mbadzioch/helios_dac/hardware/Kicad_PCB_helios/Helios.kicad_pcb

## KiCad design hardware/Kicad_PCB_helios/Helios.kicad_pcb (2017-06-14)

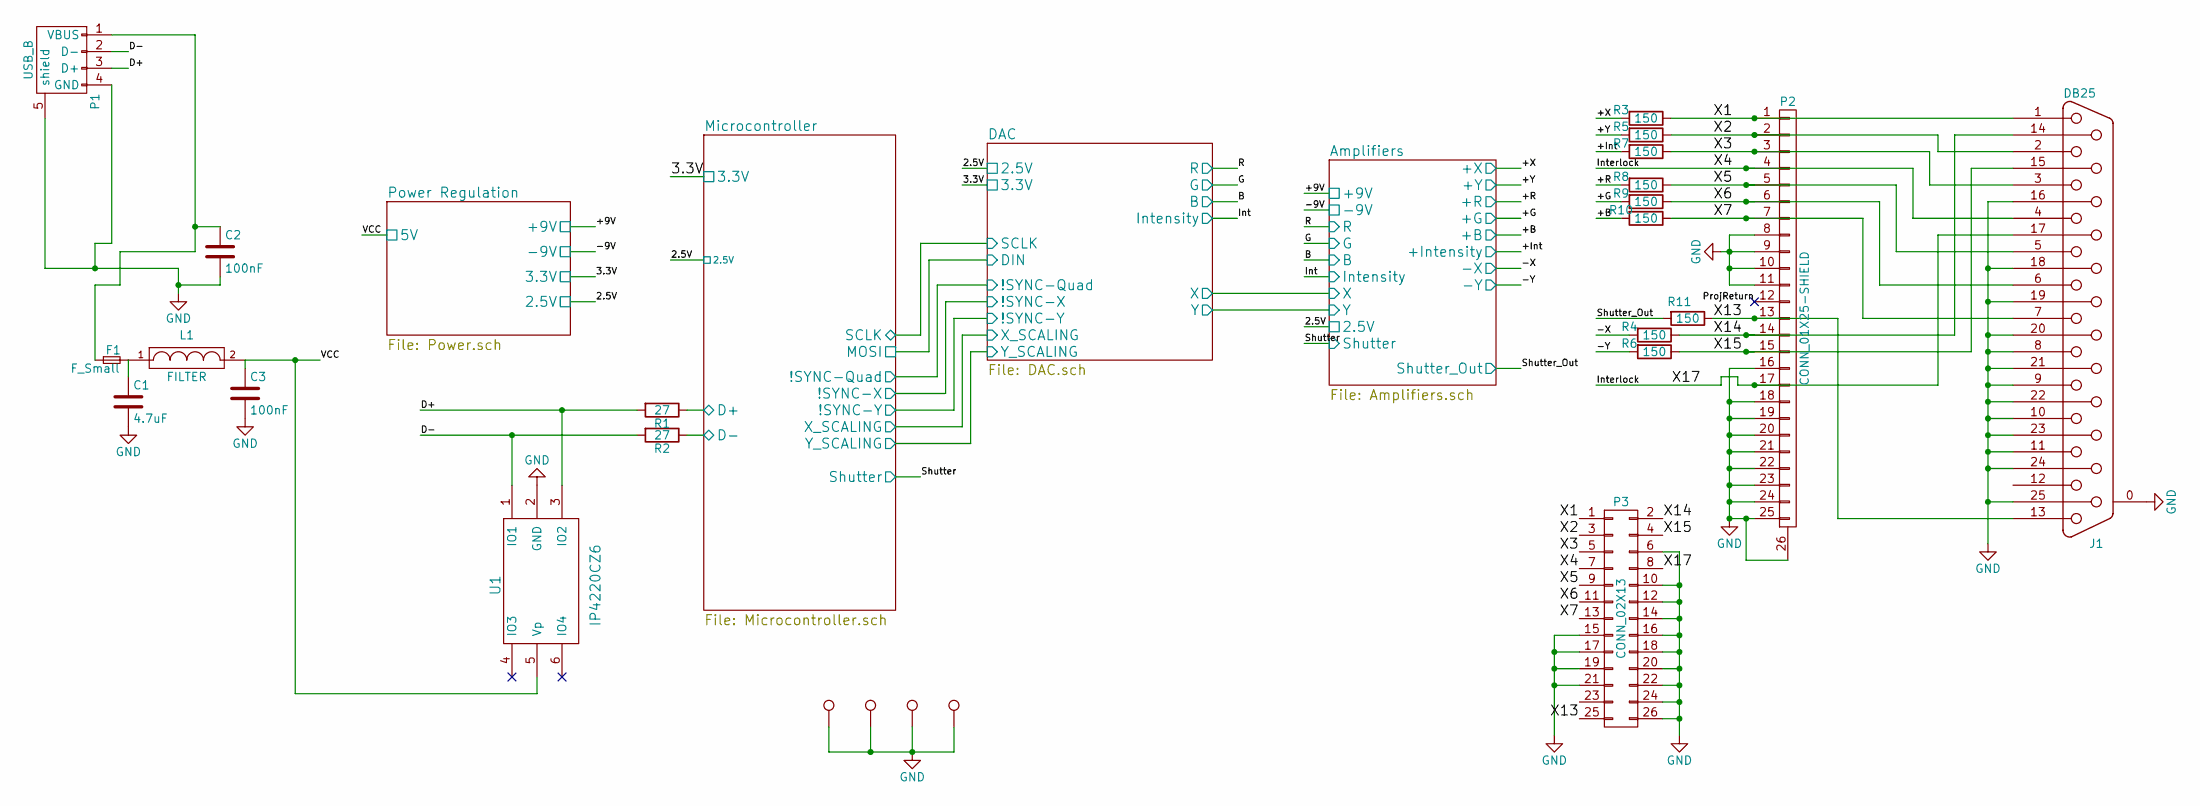
[picture p1: schematic Helios.sch, Main]

Parts:
C1: 4.7uF; c_elec_4x5.3
C2, C3: 100nF; C_0603
F1: F_Small; R_1206
J1: DB25; DB25FD
L1: FILTER; R_0603
P1: USB_B
P2: CONN_01X25-SHIELD
P3: CONN_02X13; IDC_Header_Straight_26pins
R1, R2: 27; R_0603
R3, R4, R5, R6, R7, R8, R9, R10, R11: 150; R_0603
U1: IP4220CZ6; SOT457
W1, W2, W3, W4: TEST_1P; 1pin

Connections:
/+B: R10.2; also elsewhere on the board
/+G: R9.2; also elsewhere on the board
/+Int: R7.2; also elsewhere on the board
/+R: R8.2; also elsewhere on the board
/+X: R3.2; also elsewhere on the board
/+Y: R5.2; also elsewhere on the board
/-X: R4.2; also elsewhere on the board
/-Y: R6.2; also elsewhere on the board
/D+: P1.3 (D+), R1.2, U1.3 (IO2)
/D-: P1.2 (D-), R2.2, U1.1 (IO1)
/Interlock: J1.4, J1.17, P2.4, P2.17, P3.7, P3.8
/Microcontroller/D+: R1.1; also elsewhere on the board
/Microcontroller/D-: R2.1; also elsewhere on the board
/Shutter_Out: R11.2; also elsewhere on the board
/VCC: C3.1, L1.2, U1.5 (Vp); also elsewhere on the board
/X1: J1.1, P2.1, P3.1, R3.1
/X2: J1.2, P2.2, P3.3, R5.1
/X3: J1.3, P2.3, P3.5, R7.1
/X5: J1.5, P2.5, P3.9, R8.1
/X6: J1.6, P2.6, P3.11, R9.1
/X7: J1.7, P2.7, P3.13, R10.1
/X13: J1.13, P2.13, P3.25, R11.1
/X14: J1.14, P2.14, P3.2, R4.1
/X15: J1.15, P2.15, P3.4, R6.1
GND: C1.2, C2.2, C3.2, J1.0 (GND), J1.8, J1.9, J1.10, J1.11, J1.16, J1.18, J1.19, J1.20, J1.21, J1.22, J1.23, J1.24, J1.25, P1.4 (GND), P1.5 (shield), P2.8, P2.9, P2.10, P2.11, P2.16, P2.18, P2.19, P2.20, P2.21, P2.22, P2.23, P2.24, P2.25, P2.26 (Shield), P3.6, P3.10, P3.12, P3.14, P3.15, P3.16, P3.17, P3.18, P3.19, P3.20, P3.21, P3.22, P3.24, P3.26, U1.2 (GND), W1.1, W2.1, W3.1, W4.1; also elsewhere on the board
unnamed: C1.1, F1.2, L1.1
unnamed: C2.1, F1.1, P1.1 (VBUS)

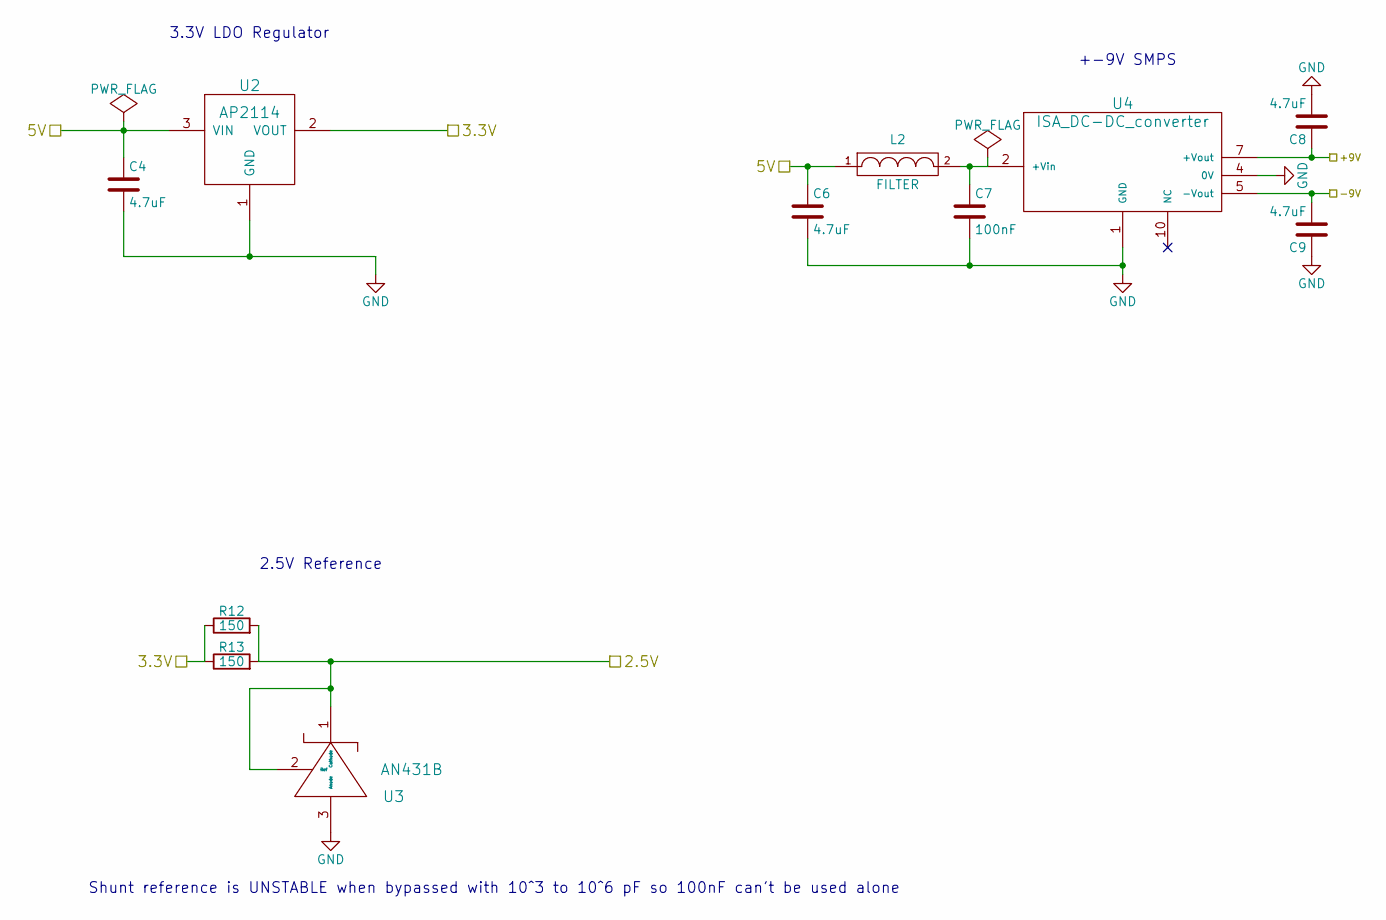
[picture p2: schematic Power.sch, Power Supplies]

Parts:
C4, C6, C8, C9: 4.7uF; c_elec_4x5.3
C7: 100nF; C_0603
L2: FILTER; R_0603
R12, R13: 150; R_0603
U2: AP2114; SOT-223
U3: AN431B; SOT-23
U4: ISA_DC-DC_converter; 10-SMD-6

Connections:
/2.5V: R12.2, R13.2, U3.1 (Cathode), U3.2 (Ref); also elsewhere on the board
/3.3V: R12.1, R13.1, U2.2 (VOUT); also elsewhere on the board
/+9V: C8.1, U4.7 (+Vout); also elsewhere on the board
/-9V: C9.2, U4.5 (-Vout); also elsewhere on the board
/VCC: C4.1, C6.1, L2.1, U2.3 (VIN); also elsewhere on the board
GND: C4.2, C6.2, C7.2, C8.2, C9.1, U2.1 (GND), U3.3 (Anode), U4.1 (GND), U4.4 (0V); also elsewhere on the board
unnamed: C7.1, L2.2, U4.2 (+Vin)

Notes on the sheet:
3.3V LDO Regulator
+-9V SMPS
2.5V Reference
Shunt reference is UNSTABLE when bypassed with 10^3 to 10^6 pF so 100nF can't be used alone

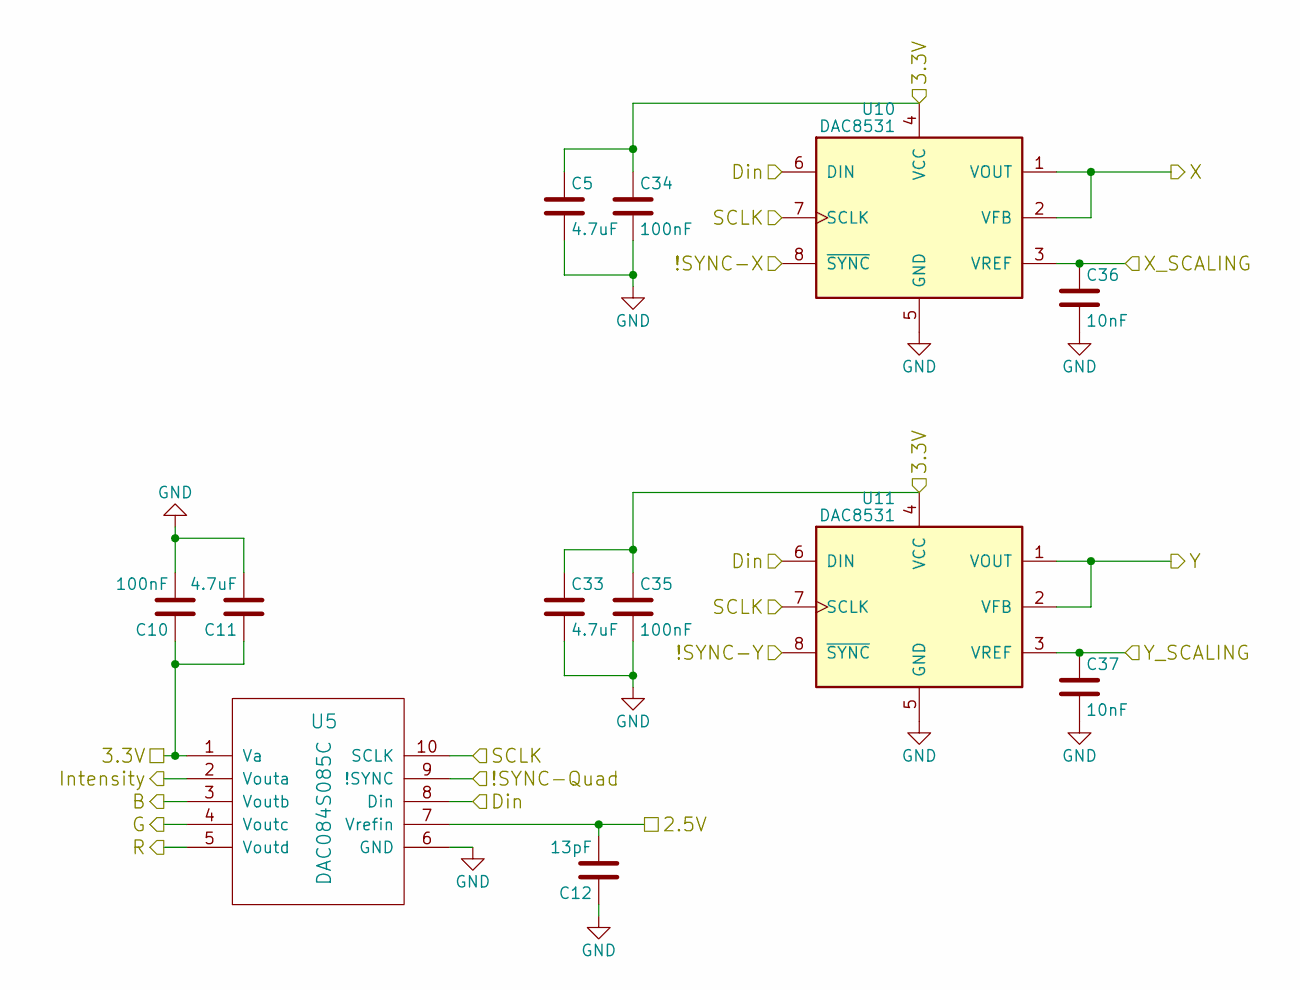
[picture p3: schematic DAC.sch, Digital to Analog Converter]

Parts:
C5: 4.7uF; CP_Elec_4x5.3
C10, C34, C35: 100nF; C_0603
C11: 4.7uF; c_elec_4x5.3
C12: 13pF; C_0603
C33: 4.7uF
C36, C37: 10nF; C_0603
U5: DAC084S085C; MSOP-10_3x3mm_Pitch0.5mm
U10, U11: DAC8531; SOT-23-8_Handsoldering

Connections:
/2.5V: C12.2, U5.7 (Vrefin); also elsewhere on the board
/3.3V: C5.1, C10.1, C11.1, C33.1, C34.1, C35.1, U5.1 (Va), U10.4 (VCC), U11.4 (VCC); also elsewhere on the board
/Amplifiers/X: U10.1 (VOUT), U10.2 (VFB); also elsewhere on the board
/Amplifiers/Y: U11.1 (VOUT), U11.2 (VFB); also elsewhere on the board
/B: U5.3 (Voutb); also elsewhere on the board
/DAC/!SYNC-Quad: U5.9 (!SYNC); also elsewhere on the board
/DAC/!SYNC-X: U10.8 (~SYNC); also elsewhere on the board
/DAC/!SYNC-Y: U11.8 (~SYNC); also elsewhere on the board
/DAC/Din: U5.8 (Din), U10.6 (DIN), U11.6 (DIN); also elsewhere on the board
/DAC/SCLK: U5.10 (SCLK), U10.7 (SCLK), U11.7 (SCLK); also elsewhere on the board
/DAC/X_SCALING: C36.1, U10.3 (VREF); also elsewhere on the board
/DAC/Y_SCALING: C37.1, U11.3 (VREF); also elsewhere on the board
/G: U5.4 (Voutc); also elsewhere on the board
/Int: U5.2 (Vouta); also elsewhere on the board
/R: U5.5 (Voutd); also elsewhere on the board
GND: C5.2, C10.2, C11.2, C12.1, C33.2, C34.2, C35.2, C36.2, C37.2, U5.6 (GND), U10.5 (GND), U11.5 (GND); also elsewhere on the board

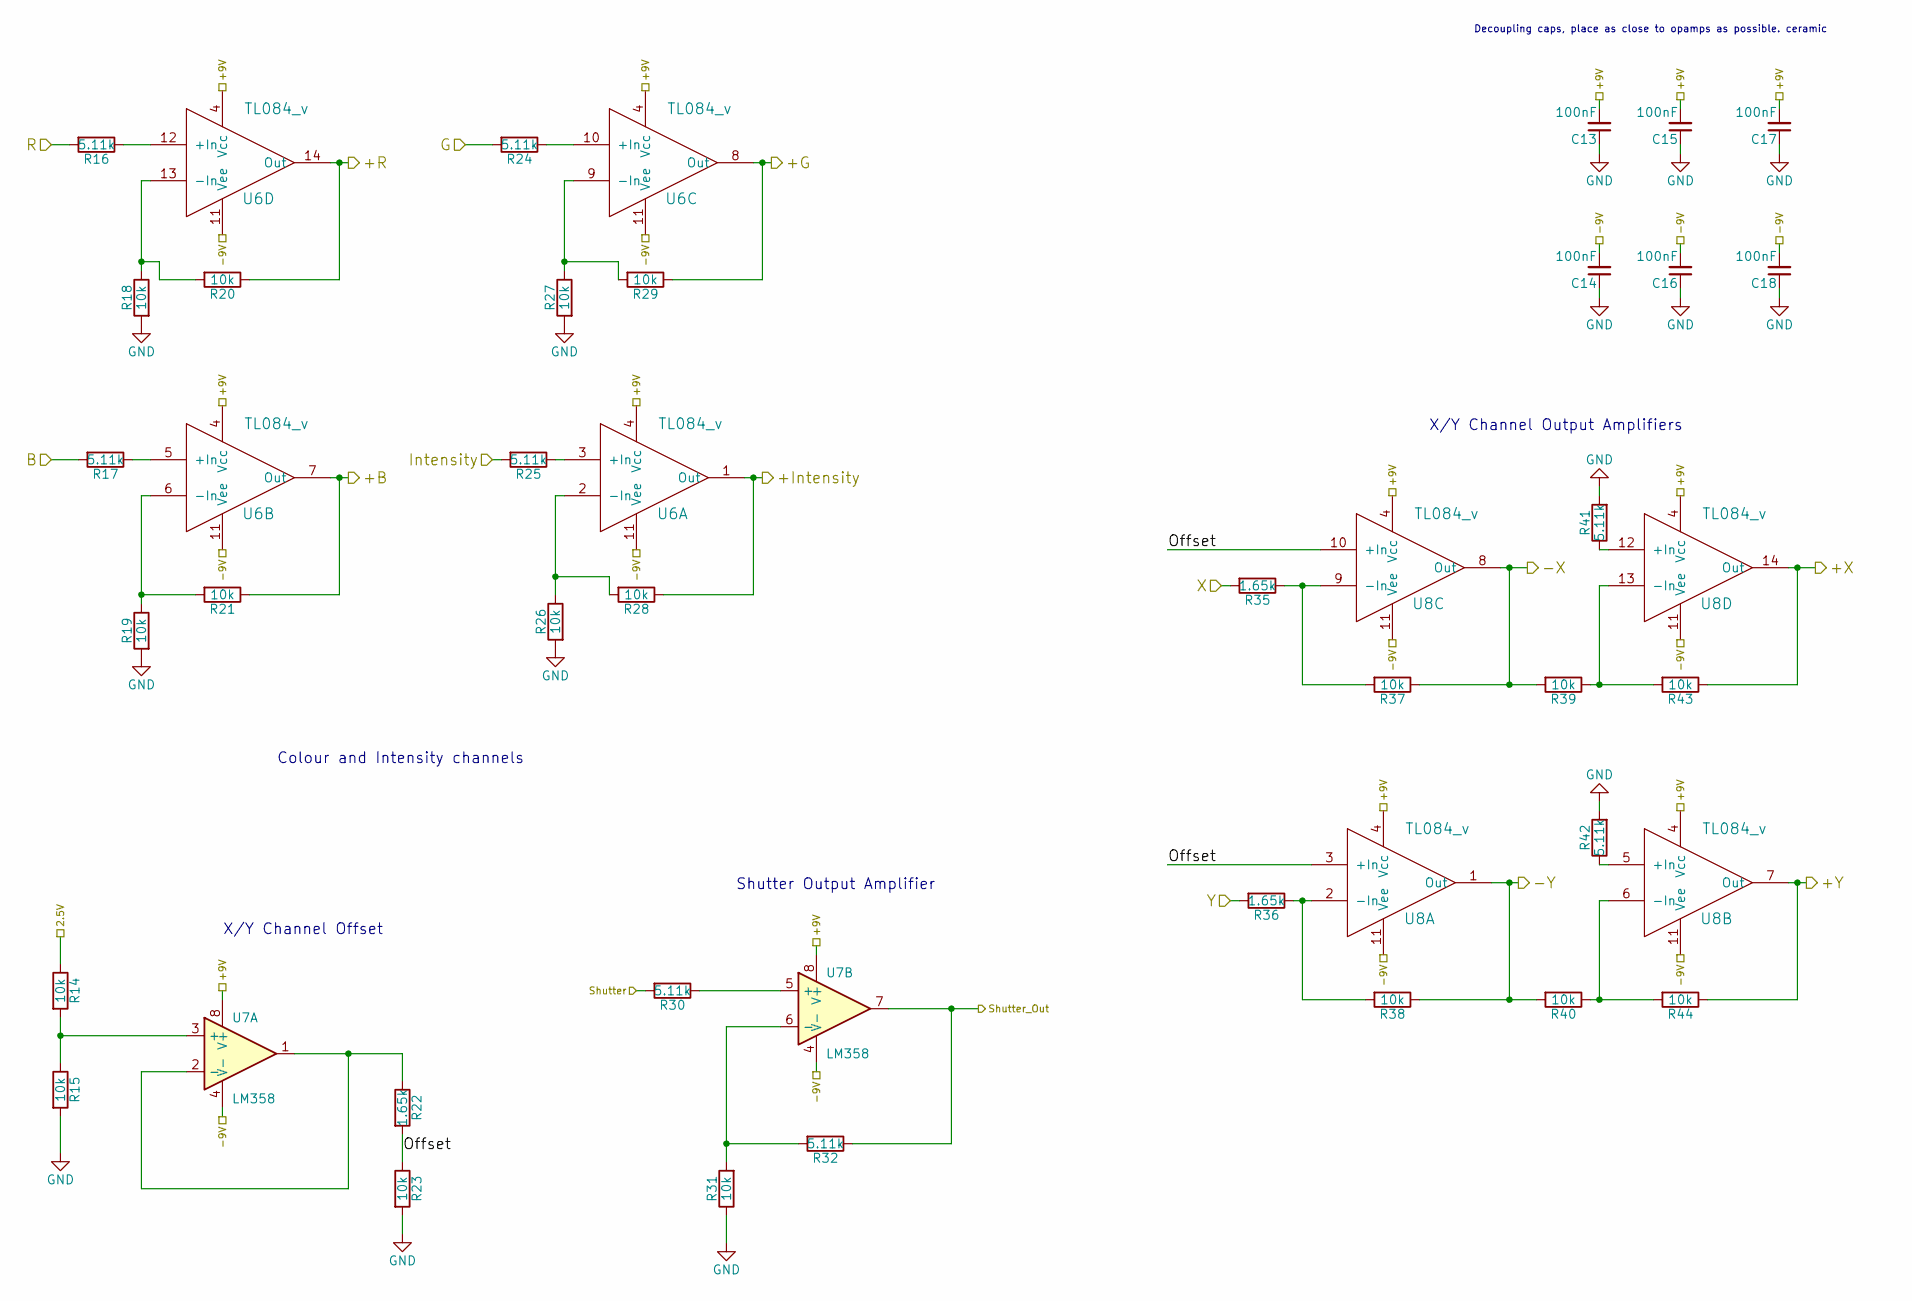
[picture p4: schematic Amplifiers.sch]

Parts:
C13, C14, C15, C16, C17, C18: 100nF; C_0603
R14, R15, R18, R19, R20, R21, R23, R26, R27, R28, R29, R31, R37, R38, R39, R40, R43, R44: 10k; R_0603
R16, R17, R24, R25, R30, R32, R41, R42: 5.11k; R_0603
R22, R35, R36: 1.65k; R_0603
U6, U8: TL084_v; TSSOP-14_4.4x5mm_Pitch0.65mm
U7: LM358; SOIC-8_3.9x4.9mm_Pitch1.27mm

Connections:
/2.5V: R14.1; also elsewhere on the board
/+9V: C13.2, C15.2, C17.2, U6.4 (Vcc), U7.8 (V+), U8.4 (Vcc); also elsewhere on the board
/+B: R21.1, U6.7 (Out); also elsewhere on the board
/+G: R29.1, U6.8 (Out); also elsewhere on the board
/+Int: R28.1, U6.1 (Out); also elsewhere on the board
/+R: R20.1, U6.14 (Out); also elsewhere on the board
/+X: R43.1, U8.14 (Out); also elsewhere on the board
/+Y: R44.1, U8.7 (Out); also elsewhere on the board
/-9V: C14.2, C16.2, C18.2, U6.11 (Vee), U7.4 (V-), U8.11 (Vee); also elsewhere on the board
/-X: R37.1, R39.2, U8.8 (Out); also elsewhere on the board
/-Y: R38.1, R40.2, U8.1 (Out); also elsewhere on the board
/Amplifiers/Offset: R22.2, R23.1, U8.3 (+In), U8.10 (+In)
/Amplifiers/X: R35.2; also elsewhere on the board
/Amplifiers/Y: R36.2; also elsewhere on the board
/B: R17.2; also elsewhere on the board
/G: R24.2; also elsewhere on the board
/Int: R25.2; also elsewhere on the board
/R: R16.2; also elsewhere on the board
/Shutter: R30.2; also elsewhere on the board
/Shutter_Out: R32.1, U7.7; also elsewhere on the board
GND: C13.1, C14.1, C15.1, C16.1, C17.1, C18.1, R15.2, R18.2, R19.2, R23.2, R26.2, R27.2, R31.1, R41.2, R42.2; also elsewhere on the board
unnamed: R14.2, R15.1, U7.3 (+)
unnamed: R16.1, U6.12 (+In)
unnamed: R17.1, U6.5 (+In)
unnamed: R18.1, R20.2, U6.13 (-In)
unnamed: R19.1, R21.2, U6.6 (-In)
unnamed: R22.1, U7.1, U7.2 (-)
unnamed: R24.1, U6.10 (+In)
unnamed: R25.1, U6.3 (+In)
unnamed: R26.1, R28.2, U6.2 (-In)
unnamed: R27.1, R29.2, U6.9 (-In)
unnamed: R30.1, U7.5 (+)
unnamed: R31.2, R32.2, U7.6 (-)
unnamed: R35.1, R37.2, U8.9 (-In)
unnamed: R36.1, R38.2, U8.2 (-In)
unnamed: R39.1, R43.2, U8.13 (-In)
unnamed: R40.1, R44.2, U8.6 (-In)
unnamed: R41.1, U8.12 (+In)
unnamed: R42.1, U8.5 (+In)

Notes on the sheet:
Decoupling caps, place as close to opamps as possible. ceramic
Colour and Intensity channels
Shutter Output Amplifier
X/Y Channel Offset
X/Y Channel Output Amplifiers

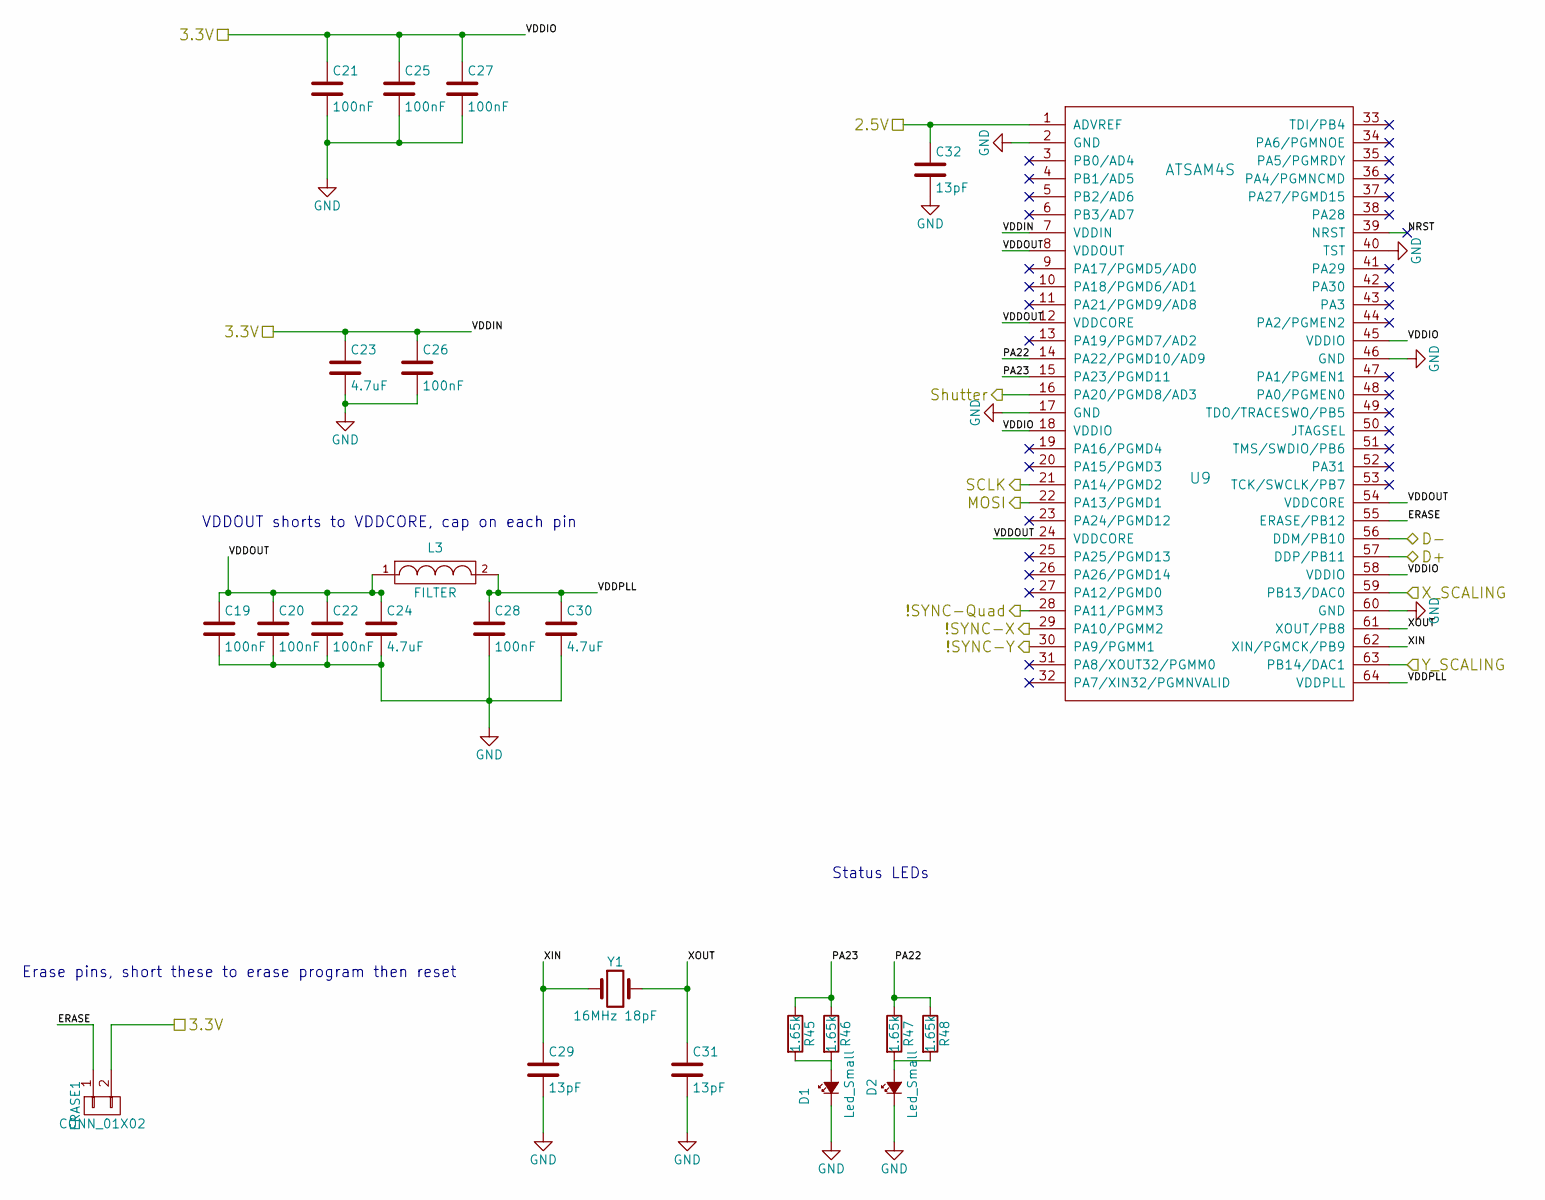
[picture p5: schematic Microcontroller.sch, Microcontroller]

Parts:
C19, C20, C21, C22, C25, C26, C27, C28: 100nF; C_0603
C23, C24, C30: 4.7uF; c_elec_4x5.3
C29, C31: 13pF; C_0603_HandSoldering
C32: 13pF; C_0603
D1, D2: Led_Small; LED_0603
ERASE1: CONN_01X02; Pin_Header_Straight_1x02_Pitch2.54mm
L3: FILTER; R_0603
R45, R46, R47, R48: 1.65k; R_0603
U9: ATSAM4S; LQFP-64_10x10mm_Pitch0.5mm
Y1: 16MHz 18pF; Crystal_HC49-SD_SMD; Part ABLS-16.000MHZ-D-4-T

Connections:
/2.5V: C32.1, U9.1 (ADVREF); also elsewhere on the board
/3.3V: C21.1, C23.1, C25.1, C26.1, C27.1, ERASE1.2, U9.7 (VDDIN), U9.18 (VDDIO), U9.45 (VDDIO), U9.58 (VDDIO); also elsewhere on the board
/DAC/!SYNC-Quad: U9.28 (PA11/PGMM3); also elsewhere on the board
/DAC/!SYNC-X: U9.29 (PA10/PGMM2); also elsewhere on the board
/DAC/!SYNC-Y: U9.30 (PA9/PGMM1); also elsewhere on the board
/DAC/Din: U9.22 (PA13/PGMD1); also elsewhere on the board
/DAC/SCLK: U9.21 (PA14/PGMD2); also elsewhere on the board
/DAC/X_SCALING: U9.59 (PB13/DAC0); also elsewhere on the board
/DAC/Y_SCALING: U9.63 (PB14/DAC1); also elsewhere on the board
/Microcontroller/D+: U9.57 (DDP/PB11); also elsewhere on the board
/Microcontroller/D-: U9.56 (DDM/PB10); also elsewhere on the board
/Microcontroller/ERASE: ERASE1.1, U9.55 (ERASE/PB12)
/Microcontroller/PA22: R47.1, R48.1, U9.14 (PA22/PGMD10/AD9)
/Microcontroller/PA23: R45.1, R46.1, U9.15 (PA23/PGMD11)
/Microcontroller/VDDOUT: C19.1, C20.1, C22.1, C24.1, L3.1, U9.8 (VDDOUT), U9.12 (VDDCORE), U9.24 (VDDCORE), U9.54 (VDDCORE)
/Microcontroller/VDDPLL: C28.1, C30.1, L3.2, U9.64 (VDDPLL)
/Microcontroller/XIN: C29.1, U9.62 (XIN/PGMCK/PB9), Y1.1
/Microcontroller/XOUT: C31.1, U9.61 (XOUT/PB8), Y1.2
/Shutter: U9.16 (PA20/PGMD8/AD3); also elsewhere on the board
GND: C19.2, C20.2, C21.2, C22.2, C23.2, C24.2, C25.2, C26.2, C27.2, C28.2, C29.2, C30.2, C31.2, C32.2, D1.1 (K), D2.1 (K), U9.2 (GND), U9.17 (GND), U9.40 (TST), U9.46 (GND), U9.60 (GND); also elsewhere on the board
unnamed: D1.2 (A), R45.2, R46.2
unnamed: D2.2 (A), R47.2, R48.2

Notes on the sheet:
Erase pins, short these to erase program then reset
Status LEDs
VDDOUT shorts to VDDCORE, cap on each pin

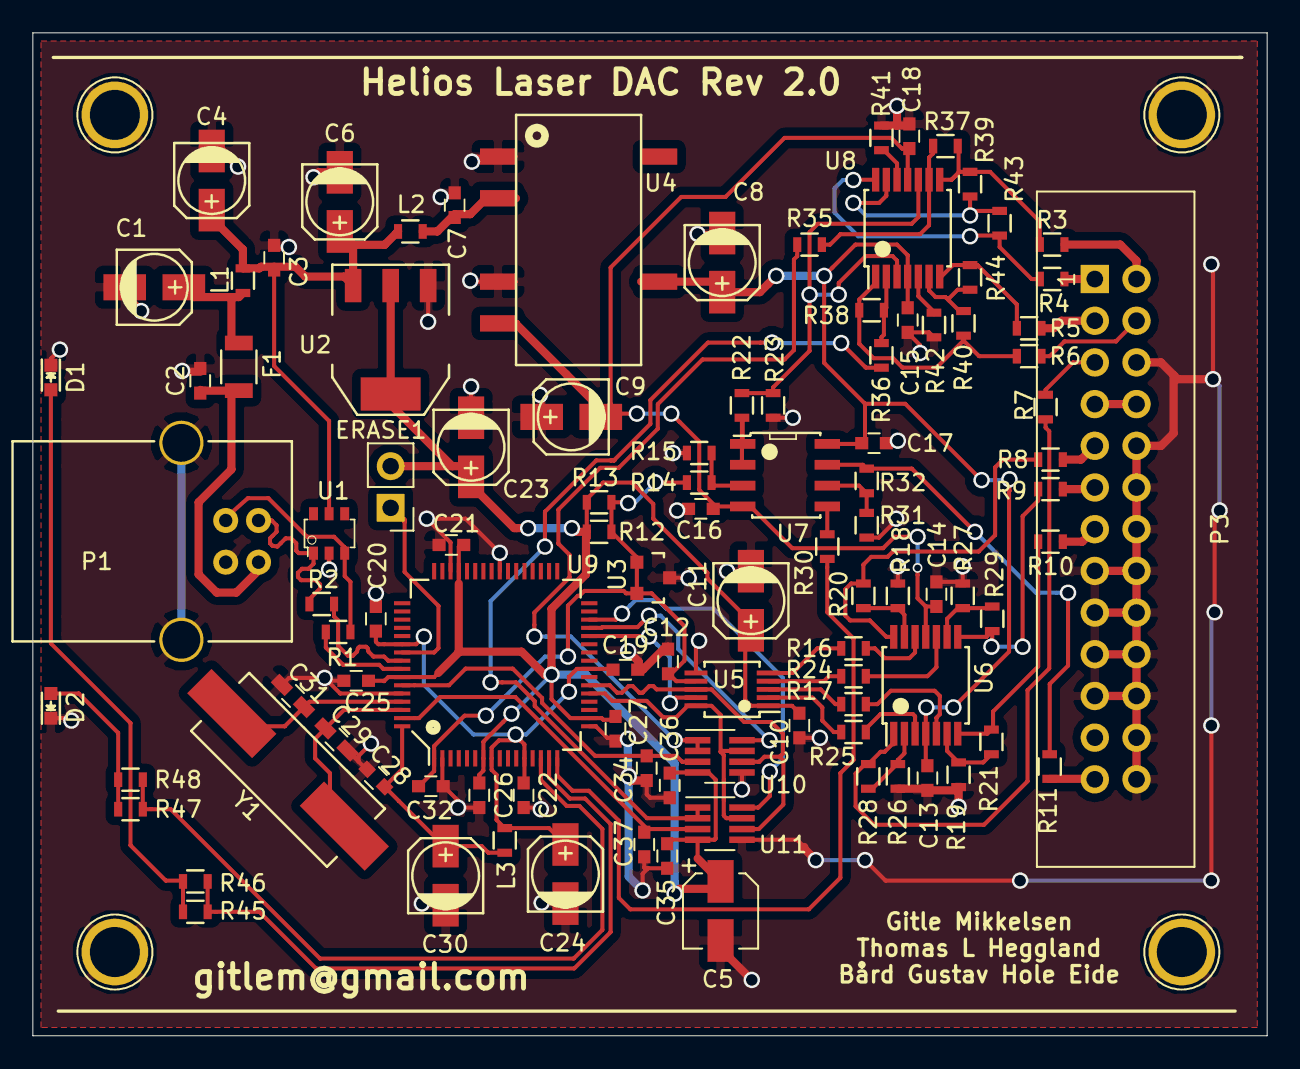
[picture p6: board Helios.kicad_pcb from above]

Board: 2 copper layers, 75.2 x 61.1 mm, 108 parts (1 on the bottom side), 74 nets.

Other parts of the board:
W5: TEST_1P; WEEE-Logo_14x20mm_SilkScreen
