mbadzioch/helios_dac/firmware/AtmelStudio_helios/lasdac_mainfirmware/src/main.c

/*
Helios Laser DAC main AS project (for SAM4S2B board)
By Gitle Mikkelsen, Creative Commons Attribution-NonCommercial 4.0 International Public License
gitlem@gmail.com


Required Atmel Software Framework modules:
	DACC - Digital-to-Analog Converter
	Flash
	Generic Board Support (ATSAM4S2B)
	GPIO
	IOPORT
	SPI - Serial Peripheral Interface
	USB Device Vendor Class
	WDT - Watchdog Timer
*/

#include "main.h"

//ENTRY
int main (void)
{
	//allocate memory to buffers
	frameAddress = malloc(MAXFRAMESIZE * 8 + 9);
	newFrameAddress = malloc(MAXFRAMESIZE * 8 + 9);
	usbInterruptBufferAddress = malloc(32);
	
	//start modules
	sysclk_init();
	pmc_disable_all_periph_clk();
	pmc_disable_pllbck();
	dac_init();
	spi_init();
	iopins_init();
	irq_initialize_vectors();
	cpu_irq_enable();
	sleepmgr_init();
	udc_start();
	wdt_setup();
	timer_init();
	flash_init(FLASH_ACCESS_MODE_128, 4);
	
	//set systick higher priority to avoid jitter in playback when processing USB transfers
	NVIC_SetPriority(UDP_IRQn, 2);
	NVIC_SetPriority(SysTick_IRQn, 1);
	
	//default output
	shutter_set(LOW);
	statusled_set(LOW);
	ioport_set_pin_level(PIN_POWERLED, HIGH);
	stop_weak();
	
	sleepmgr_lock_mode(SLEEPMGR_WAIT_FAST);
	
	assign_default_name();
	
	//waiting for interrupts..
	while (1)
	{
		wdt_restart(WDT);
		sleepmgr_enter_sleep();
	}
}

void SysTick_Handler() //systick timer ISR, called for each point
{
	if (playing && !stopFlag && connected)
	{
		if (framePos >= frameSize) //if frame reached the end
		{
			if (newFrameReady)
			{
				//load new frame, switch buffers
				uint8_t* previousFrameAddress = frameAddress;
				frameAddress = newFrameAddress;
				newFrameAddress = previousFrameAddress;
				framePos = 0;
				frameSize = newFrameSize;
				notRepeat = newNotRepeat;
				point_output();
				framePos += 8;
				speed_set(outputSpeed);
				
				update_status();
			}
			else
			{
				if (!notRepeat)
				{
					//loop frame
					framePos = 0;
					point_output();
					framePos += 8;
				}
				else
				{
					stop_weak();
					update_status();
				}
			}
		}
		else
		{
			//output current point
			point_output();
			framePos += 8;
		}
	}
}

void usb_bulk_out_callback(udd_ep_status_t status, iram_size_t length, udd_ep_id_t ep)
{
	UNUSED(ep);
	
	if (!connected)
	return;
	
	//0-n:	frame data, each point is 16-bit X little endian, 16bit Y little endian, 8bit R, 8bit G, 8bit B, 8bit I
	//n:	output rate 16bit little endian
	//n+2:	frame size in points 16bit little endian
	//n+4:	flags
		
	if ( (status == UDD_EP_TRANSFER_OK) && (length <= MAXFRAMESIZE * 8 + 9) && !stopFlag) //if not invalid
	{
		uint16_t numOfPointBytes = length - 9; //from length of received data
		uint16_t numOfPointBytes2 = ((newFrameAddress[numOfPointBytes + 3] << 8) | newFrameAddress[numOfPointBytes + 2]) * 8; //from control bytes
		
		if (numOfPointBytes == numOfPointBytes2) //sanity check, skip frame if conflicting frame size information
		{
			cpu_irq_enter_critical();
				uint8_t flags = newFrameAddress[numOfPointBytes + 4];
				newNotRepeat = (flags & (1 << 1));
				outputSpeed = (newFrameAddress[numOfPointBytes + 1] << 8) | newFrameAddress[numOfPointBytes + 0];		
				
				//voltage references, 12 bit up to 0xFFF	
				uint16_t vRefA = (newFrameAddress[numOfPointBytes + 1] << 8) | newFrameAddress[numOfPointBytes + 0];	
				if (vRefA > 0xFFF) vRefA = 0xFFF;
				uint16_t vRefB = (newFrameAddress[numOfPointBytes + 1] << 8) | newFrameAddress[numOfPointBytes + 0];
				if (vRefB > 0xFFF) vRefB = 0xFFF;	

			
				if ( (!playing) || (flags & (1 << 0)) ) //if frame is to start playing immediately
				{
					uint8_t* previousFrameAddress = frameAddress;
					frameAddress = newFrameAddress;
					newFrameAddress = previousFrameAddress;
					framePos = 0;
					frameSize = numOfPointBytes;
					playing = true;
					notRepeat = newNotRepeat;
					speed_set(outputSpeed);

					//update voltage ref dacs
					if ((dacc_get_interrupt_status(DACC) & DACC_ISR_TXRDY) == DACC_ISR_TXRDY) //if DAC ready
					{
						posData = ((vRefA << 16)) | ((1 << 12) | vRefB);
						dacc_write_conversion_data(DACC, posData );
					}
					
					update_status();
				} 
				else
				{
					newFrameSize = numOfPointBytes;
					newFrameReady = true;
				}
			cpu_irq_leave_critical();
		}
	}
}

void usb_interrupt_out_callback(udd_ep_status_t status, iram_size_t length, udd_ep_id_t ep)
{
	//LSB: Command
	//MSB: Data

	UNUSED(ep);
	
	if (!connected)
	return;
	
	if (status == UDD_EP_TRANSFER_OK)
	{	
		if (usbInterruptBufferAddress[0] == 0x01)		//STOP
		{
			stop();
		}
		else if (usbInterruptBufferAddress[0] == 0x02)	//SHUTTER
		{
			shutter_set( (usbInterruptBufferAddress[1] && true) );
		}
		else if (usbInterruptBufferAddress[0] == 0x03)	//STATUS/NEW FRAME POLL (deprecated)
		{
			uint8_t transfer[2] = {0x83, 0};
			if (!newFrameReady)
			{
				udi_vendor_bulk_out_run(newFrameAddress, MAXFRAMESIZE * 8 + 9, usb_bulk_out_callback);
				transfer[1] = 1;	
			}
			
			udi_vendor_interrupt_in_run(&transfer[0], 2, NULL);
		}
		else if (usbInterruptBufferAddress[0] == 0x04)	//GET FIRMWARE VERSION
		{
			uint8_t transfer[5] = {0x84,(uint8_t)(FIRMWARE_VERSION >> 0),
										(uint8_t)(FIRMWARE_VERSION >> 8),
										(uint8_t)(FIRMWARE_VERSION >> 16),
										(uint8_t)(FIRMWARE_VERSION >> 24)};
										
			udi_vendor_interrupt_in_run(&transfer[0], 5, NULL);
		}
		else if (usbInterruptBufferAddress[0] == 0x05)	//GET NAME
		{
			uint8_t transfer[32];
			transfer[0] = 0x85;
			uint32_t flashBuf[32];
			flash_read_user_signature(&flashBuf[0], 32);
			int i;
			for (i = 0; i < 31; i++)
			{
				transfer[1+i] = flashBuf[i];
				if (flashBuf[i] == 0)
					break;
			}
			
			udi_vendor_interrupt_in_run(&transfer[0], 32, NULL);
		}
		else if (usbInterruptBufferAddress[0] == 0x06)	//WRITE NAME
		{
			uint32_t flash[31];
			int i;
			for (i = 0; i < 31; i++)
			{
				flash[i] = (uint32_t)usbInterruptBufferAddress[1+i];
			}
			flash_erase_user_signature();
			flash_write_user_signature((void*)&flash[0], 32);
		}
		else if (usbInterruptBufferAddress[0] == 0x07)	//GET SDK VERSION
		{
			sdkVersion = usbInterruptBufferAddress[1];
		}
		else if (usbInterruptBufferAddress[0] == 0xDE)	//ERASE GPNVM BIT, BOOT TO FIRMWARE UPDATE BOOTLOADER
		{
			stop_weak();
			flash_clear_gpnvm(1);
			while (1); //watchdog should restart mcu
		}
	}
	
	udi_vendor_interrupt_out_run(usbInterruptBufferAddress, 32, usb_interrupt_out_callback);
}


inline void point_output(void) //sends point data to the DACs, data is point number "framePos" in buffer "frameAddress".
{
	uint8_t* currentPoint = frameAddress + framePos;
	
	uint16_t x = (currentPoint[0] << 8) | currentPoint[1];
	uint16_t y = (currentPoint[2] << 8) | currentPoint[3];
	//output x and y to DAC here....
	
	spi_write(SPI, (currentPoint[4] << 4) | (0b1101 << 12), 0, 0); //R
	spi_write(SPI, (currentPoint[5] << 4) | (0b1001 << 12), 0, 0); //G
	spi_write(SPI, (currentPoint[6] << 4) | (0b0101 << 12), 0, 0); //B
	spi_write(SPI, (currentPoint[7] << 4) | (0b0001 << 12), 0, 0); //I
	
	statusled_set( (currentPoint[7] != 0) ); //turn on status led if not blanked
}

void stop_weak(void) //outputs a blanked and centered point and stops playback
{
	SysTick->CTRL = SysTick_CTRL_CLKSOURCE_Msk; //disable systick IRQ
	playing = false;
	framePos = 0;
	newFrameReady = false;
	statusled_set(LOW);
	
	spi_write(SPI, (0b0010 << 12), 0, 0); //blank all colors
}

void stop(void) //outputs a blanked and centered point and stops playback
{
	stopFlag = true;
	stop_weak();
	tc_start(TC0, 0); //set timer for delayed stop in case new unwanted frame is on the way over USB
}

//timer ISR for delayed stop
void TC0_Handler(void)
{
	uint32_t dummy;
	dummy = tc_get_status(TC0, 0);
	UNUSED(dummy);
	
	tc_stop(TC0,0);
	
	stop_weak();

	//output 0x8000 and 0x8000 to XY dac here (centering)	
	
	stopFlag = false;
	
	if (connected)
		update_status();
}

void speed_set(uint32_t rate) //set the output speed in points per second
{
	if (!connected)
		return; 
		
	if (rate > MAXSPEED)
		rate = MAXSPEED;
	else if (rate < MINSPEED)
		rate = MINSPEED;
	outputSpeed = rate;
	SysTick_Config( (sysclk_get_cpu_hz() / rate) + 1);
	NVIC_SetPriority(SysTick_IRQn, 1);
}

int callback_vendor_enable(void) //usb connection opened, preparing for activity
{	
	connected = true;
	stop_weak();
	
	sleepmgr_unlock_mode(SLEEPMGR_WAIT_FAST);
	sleepmgr_lock_mode(SLEEPMGR_ACTIVE);
	
	udi_vendor_interrupt_out_run(usbInterruptBufferAddress, 32, usb_interrupt_out_callback);
	udi_vendor_bulk_out_run(newFrameAddress, MAXFRAMESIZE * 8 + 9, usb_bulk_out_callback);
	
	return 1;
}

void callback_vendor_disable(void) //usb connection closed, sleeping to save power
{
	connected = false;
	stop();
	
	sleepmgr_unlock_mode(SLEEPMGR_ACTIVE);
	sleepmgr_lock_mode(SLEEPMGR_WAIT_FAST);
}

inline void shutter_set(bool level)
{
	ioport_set_pin_level(PIN_SHUTTER, level);
}

inline void statusled_set(bool level)
{
	ioport_set_pin_level(PIN_STATUSLED, level);
}

//INIT FUNCTIONS:

void iopins_init(void) //setup io pins config
{
	ioport_set_pin_dir(PIN_SHUTTER, IOPORT_DIR_OUTPUT);
	ioport_set_pin_dir(PIN_STATUSLED, IOPORT_DIR_OUTPUT);
	ioport_set_pin_dir(PIN_POWERLED, IOPORT_DIR_OUTPUT);
	
	//ioport_set_pin_dir(PIN_DEBUG1, IOPORT_DIR_OUTPUT);
	//ioport_set_pin_level(PIN_DEBUG1, LOW);
	//ioport_set_pin_dir(PIN_DEBUG2, IOPORT_DIR_OUTPUT);
	//ioport_set_pin_level(PIN_DEBUG2, LOW);
}

void spi_init(void) //setup SPI for DAC084S085
{
	gpio_configure_pin(SPI_MISO_GPIO, SPI_MISO_FLAGS);
	gpio_configure_pin(SPI_MOSI_GPIO, SPI_MOSI_FLAGS);
	gpio_configure_pin(SPI_SPCK_GPIO, SPI_SPCK_FLAGS);
	gpio_configure_pin(SPI_NPCS0_GPIO, SPI_NPCS0_FLAGS);
	spi_enable_clock(SPI);
	spi_disable(SPI);
	spi_reset(SPI);
	spi_set_master_mode(SPI);
	spi_set_fixed_peripheral_select(SPI);
	spi_disable_mode_fault_detect(SPI);
	spi_configure_cs_behavior(SPI, 0, SPI_CS_RISE_FORCED);
	spi_set_delay_between_chip_select(SPI, 6);
	spi_set_peripheral_chip_select_value(SPI, spi_get_pcs(0));
	spi_set_clock_polarity(SPI, 0, 0);
	spi_set_clock_phase(SPI, 0, 0);
	spi_set_bits_per_transfer(SPI, 0, SPI_CSR_BITS_16_BIT);
	spi_set_baudrate_div(SPI, 0, 5 ); //112MHz / 5 = 22.4 MHz
	spi_set_transfer_delay(SPI, 0, 0, 0);
	spi_enable(SPI);
}

void dac_init(void) //setup sam internal DAC controller
{
	sysclk_enable_peripheral_clock(ID_DACC);
	dacc_reset(DACC);
	dacc_enable_channel(DACC, 0);
	dacc_enable_channel(DACC, 1);
	dacc_set_transfer_mode(DACC, 1);
	dacc_enable_flexible_selection(DACC);
}

void timer_init(void) //set up timer counter for delayed stop
{
	pmc_enable_periph_clk(ID_TC0);
	uint32_t timerDiv;
	uint32_t timerClkSource;
	uint32_t timerFreq = 10; // 1s/10 = 100ms
	uint32_t sysClkFreq = sysclk_get_cpu_hz();
	tc_find_mck_divisor(timerFreq, sysClkFreq, &timerDiv, &timerClkSource, sysClkFreq);
	tc_init(TC0, 0, timerClkSource | TC_CMR_CPCTRG | TC_CMR_CPCSTOP);
	stopTimerCounts = (sysClkFreq/timerDiv)/timerFreq;
	NVIC_DisableIRQ(TC0_IRQn);
	NVIC_ClearPendingIRQ(TC0_IRQn);
	NVIC_SetPriority(TC0_IRQn,0);
	NVIC_EnableIRQ(TC0_IRQn);
	tc_enable_interrupt(TC0, 0, TC_IER_CPCS);
	tc_write_rc(TC0, 0, stopTimerCounts);
}

void wdt_setup() //setup watchdog to trigger a reset at WDT_PERIOD ms inactivity
{
	uint32_t timeout_value = wdt_get_timeout_value(WDT_PERIOD * 1000, BOARD_FREQ_SLCK_XTAL);
	uint32_t wdt_mode = WDT_MR_WDRSTEN | WDT_MR_WDDBGHLT | WDT_MR_WDIDLEHLT;
	wdt_init(WDT, wdt_mode, timeout_value, timeout_value);
}

void assign_default_name() //on first ever boot, assign default name and store to flash
{
	uint32_t flash[16];
	flash_read_user_signature(&flash[0], 16);
	if (flash[0] == 0xFFFFFFFF) //factory value
	{
		uint32_t unique[4];
		flash_read_unique_id(&unique[0], 4);
		char name[16];
		sprintf(&name[0], "Helios %ld", unique[3]);
		int i;
		for (i = 0; i < 16; i++)
		{
			flash[i] = (uint32_t)name[i];
			if (name[i] == 0)
				break;
		}
		flash_erase_user_signature();
		flash_write_user_signature((void*)&flash[0], 16);
	}
}

void update_status() // send an usb transfer telling the host driver a new frame buffer status
{
	newFrameReady = false;
}

// Below is all to make Windows automatically install driver when plugged in
// Credits: https://github.com/cjameshuff/m1k-fw/

static USB_MicrosoftCompatibleDescriptor msft_compatible = {
	.dwLength = sizeof(USB_MicrosoftCompatibleDescriptor) +
	1*sizeof(USB_MicrosoftCompatibleDescriptor_Interface),
	.bcdVersion = 0x0100,
	.wIndex = 0x0004,
	.bCount = 1,
	.reserved = {0, 0, 0, 0, 0, 0, 0},
	.interfaces = {
		{
			.bFirstInterfaceNumber = 0,
			.reserved1 = 0,
			.compatibleID = "WINUSB\0\0",
			.subCompatibleID = {0, 0, 0, 0, 0, 0, 0, 0},
			.reserved2 = {0, 0, 0, 0, 0, 0},
		}
	}
};

// WCID configuration information
// Hooked into UDC via UDC_GET_EXTRA_STRING #define.
bool msft_string_handle(void) {
	uint8_t udi_msft_magic[] = "MSFT1000";

	struct extra_strings_desc_t{
		usb_str_desc_t header;
		le16_t string[sizeof(udi_msft_magic)];
	};

	static UDC_DESC_STORAGE struct extra_strings_desc_t extra_strings_desc = {
		.header.bDescriptorType = USB_DT_STRING
	};

	uint8_t i;
	uint8_t *str;
	uint8_t str_lgt=0;

	if ((udd_g_ctrlreq.req.wValue & 0xff) == 0xEE) {
		str_lgt = sizeof(udi_msft_magic)-1;
		str = udi_msft_magic;
	}
	else {
		return false;
	}

	if (str_lgt!=0) {
		for( i=0; i<str_lgt; i++) {
			extra_strings_desc.string[i] = cpu_to_le16((le16_t)str[i]);
		}
		extra_strings_desc.header.bLength = 2+ (str_lgt)*2;
		udd_g_ctrlreq.payload_size = extra_strings_desc.header.bLength;
		udd_g_ctrlreq.payload = (uint8_t *) &extra_strings_desc;
	}

	// if the string is larger than request length, then cut it
	if (udd_g_ctrlreq.payload_size > udd_g_ctrlreq.req.wLength) {
		udd_g_ctrlreq.payload_size = udd_g_ctrlreq.req.wLength;
	}
	return true;
}

bool usb_device_specific_request(void) {
	uint8_t* ptr = 0;
	uint16_t size = 0;
	
	if (Udd_setup_type() == USB_REQ_TYPE_VENDOR) {//ioport_set_pin_level(PIN_POWERLED, LOW);
		switch (udd_g_ctrlreq.req.bRequest) {
			/// windows compatible ID handling for auto install
			case 0x30: {
				if (udd_g_ctrlreq.req.wIndex == 0x04) {
					ptr = (uint8_t*)&msft_compatible;
					size = (udd_g_ctrlreq.req.wLength);
					if (size > msft_compatible.dwLength) {
						size = msft_compatible.dwLength;
					}
					
				}
				else {
					return false;
				}
				break;
			}
		}
	}
	udd_g_ctrlreq.payload_size = size;
	if ( size == 0 ) {
		udd_g_ctrlreq.callback = 0;
		udd_g_ctrlreq.over_under_run = 0;
	}
	else {
		udd_g_ctrlreq.payload = ptr;
	}
	return true;
}
