mbadzioch/helios_dac/(commit log)

2017-06-05 Dodano 2 zewnętrzne 16 bitowe układy DAC
    Podłączono VREF do wewnętrznych DAC
    Wszystko działa na jednej magistrali SPI
    [Amplifiers.sch, DAC.sch, Helios.kicad_pcb, Helios.sch, Microcontroller.sch, Power.sch]
2017-06-14 Updated PCB Layout
    Changed connector to IDC
    [Amplifiers.sch, DAC.sch, Helios.kicad_pcb, Helios.sch, Microcontroller.sch, Power.sch]
